manoukis/olfactometer_rotor/pics/buildings_s.jpg

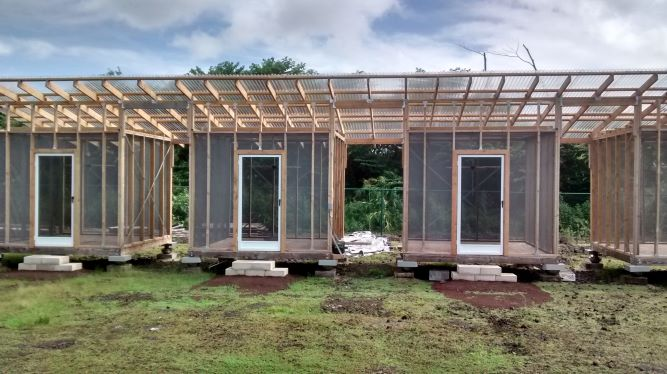
pics/buildings_s.jpg
