manoukis/olfactometer_rotor/pics/IMG_20181030_110219506.jpg

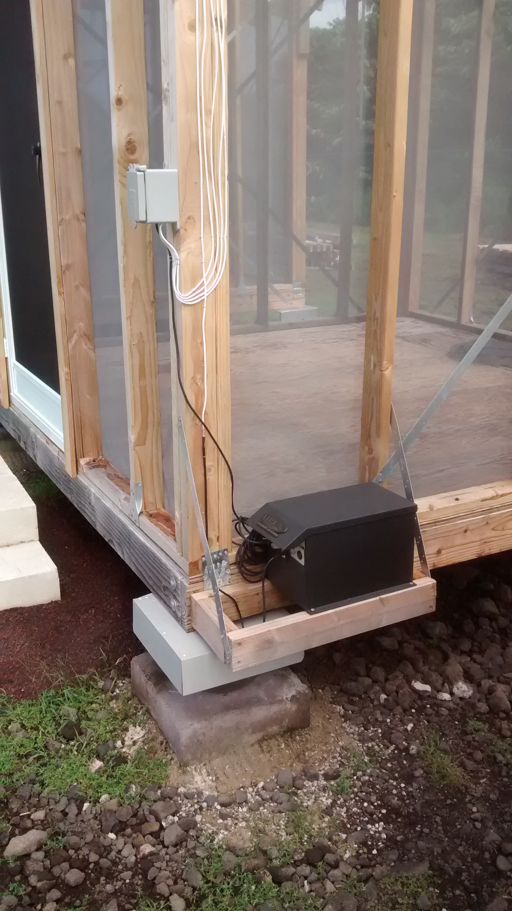
pics/IMG_20181030_110219506.jpg
