manoukis/olfactometer_rotor/README.md

# olfactometer_rotor
Designs for fly oflactometer (rotating traps)

See [PBARC Rotation Olfactometers- SOP 2018.docx](PBARC%20Rotating%20Olfactometers-%20SOP%202018.docx?raw=true) for docmentation
