manoukis/olfactometer_rotor/pics/IMG_20181030_110237050.jpg

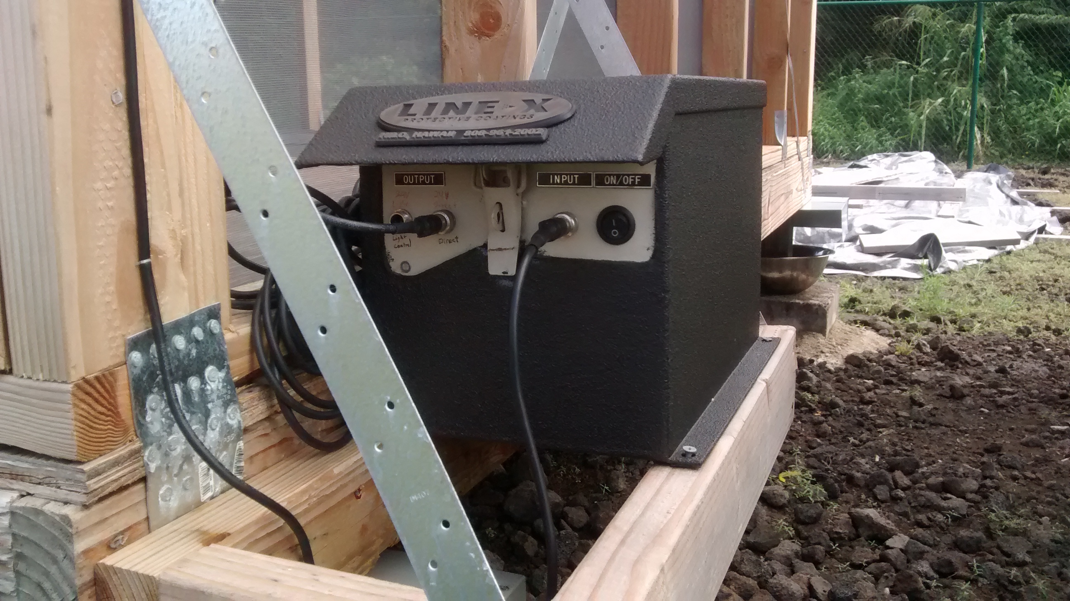
pics/IMG_20181030_110237050.jpg
