manoukis/olfactometer_rotor/pics/IMG_20181030_110251892.jpg

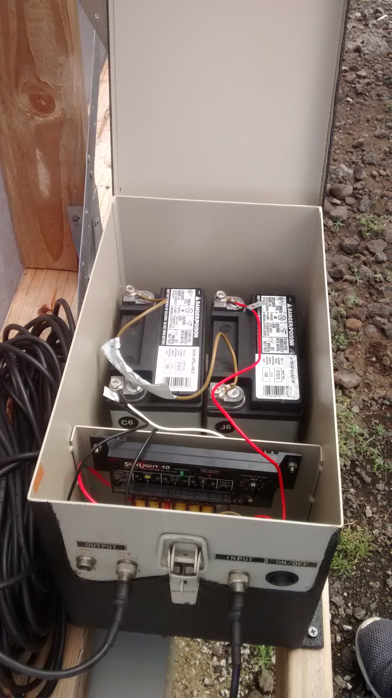
pics/IMG_20181030_110251892.jpg
