manoukis/olfactometer_rotor/pics/IMG_20181030_110327771.jpg

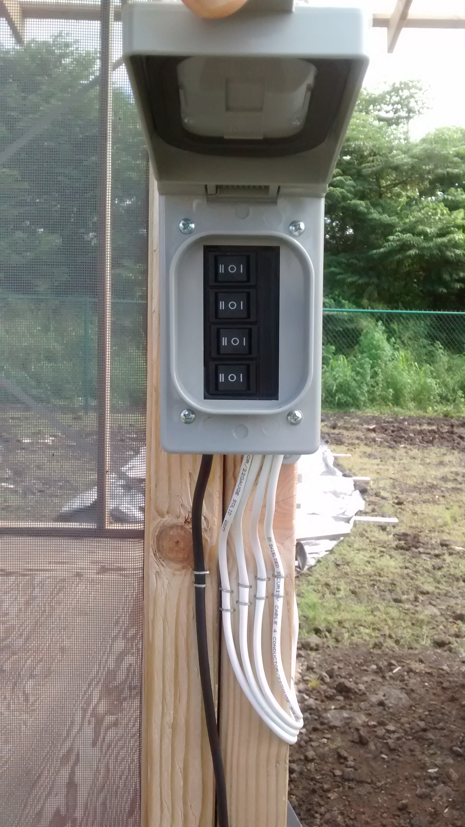
pics/IMG_20181030_110327771.jpg
