manoukis/olfactometer_rotor/pics/IMG_20181030_110353957.jpg

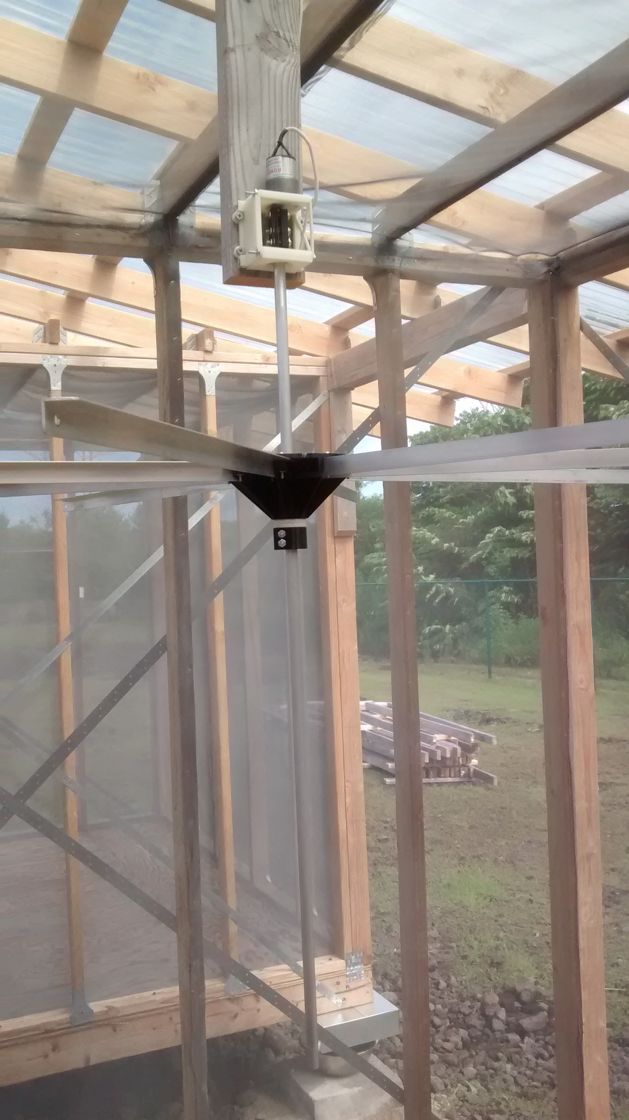
pics/IMG_20181030_110353957.jpg
