manoukis/olfactometer_rotor/pics/IMG_20181030_110401536.jpg

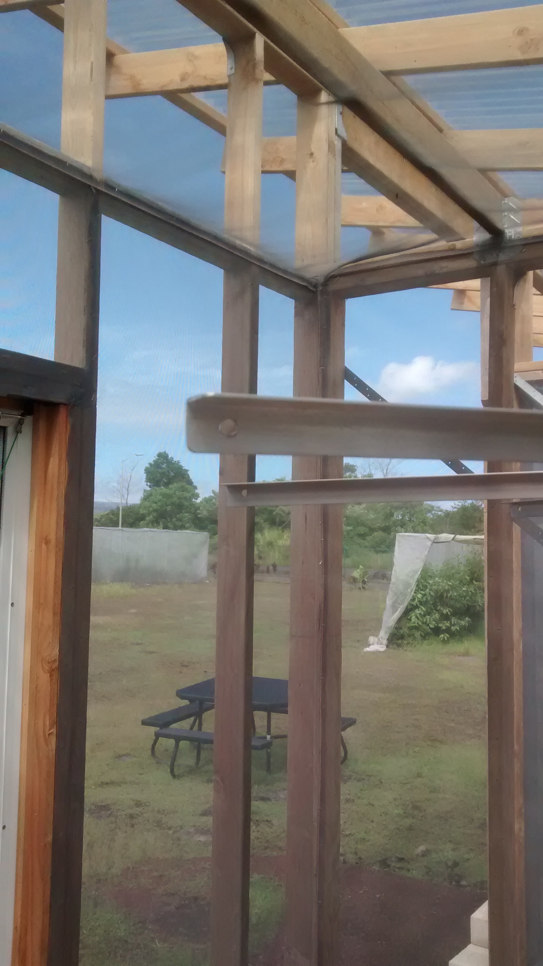
pics/IMG_20181030_110401536.jpg
