manoukis/olfactometer_rotor/pics/IMG_20181030_110407331.jpg

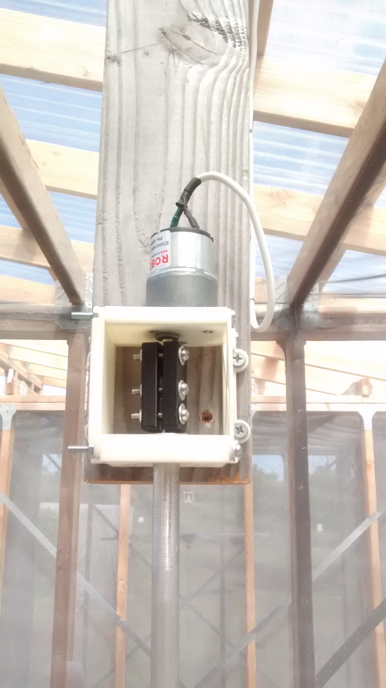
pics/IMG_20181030_110407331.jpg
