manoukis/olfactometer_rotor/pics/IMG_20181030_110427534.jpg

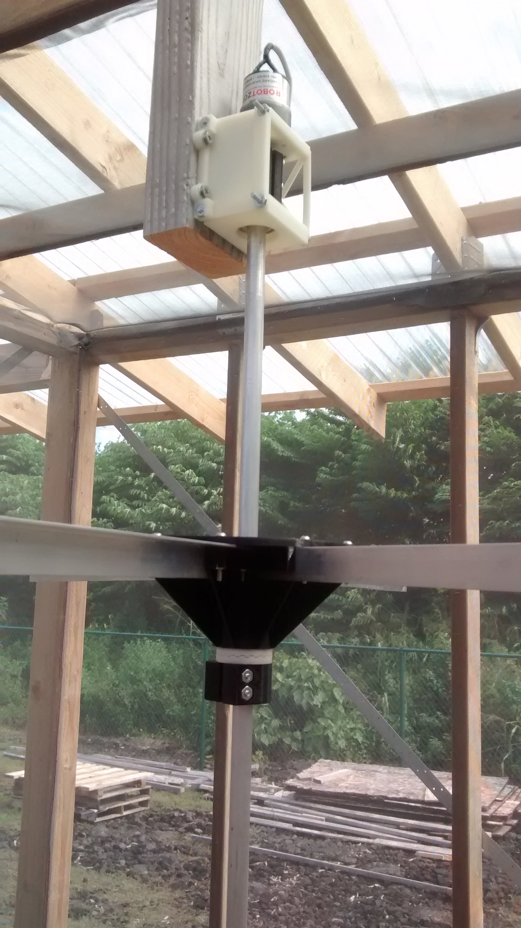
pics/IMG_20181030_110427534.jpg
