manoukis/olfactometer_rotor/pics/originals/IMG_20181030_110201760.jpg

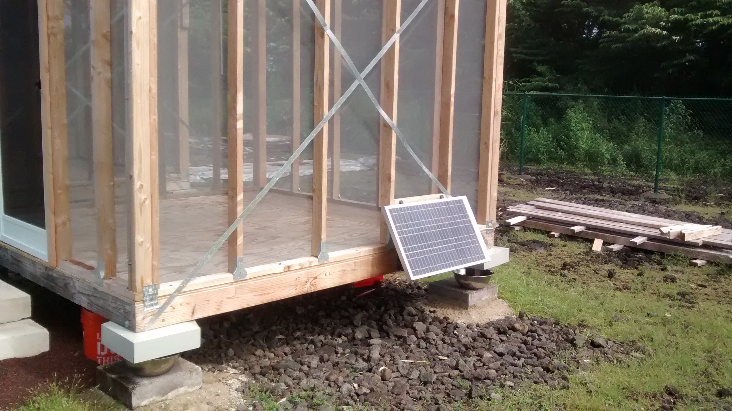
pics/originals/IMG_20181030_110201760.jpg
