manoukis/olfactometer_rotor/pics/solar_panel_s.jpg

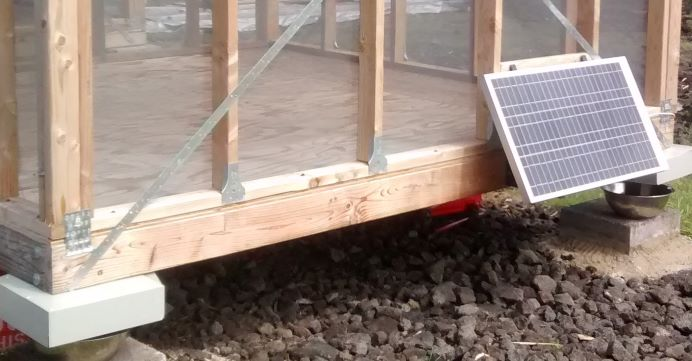
pics/solar_panel_s.jpg
