manoukis/olfactometer_rotor/part_designs/bearing_plate_v0.2.FCStd

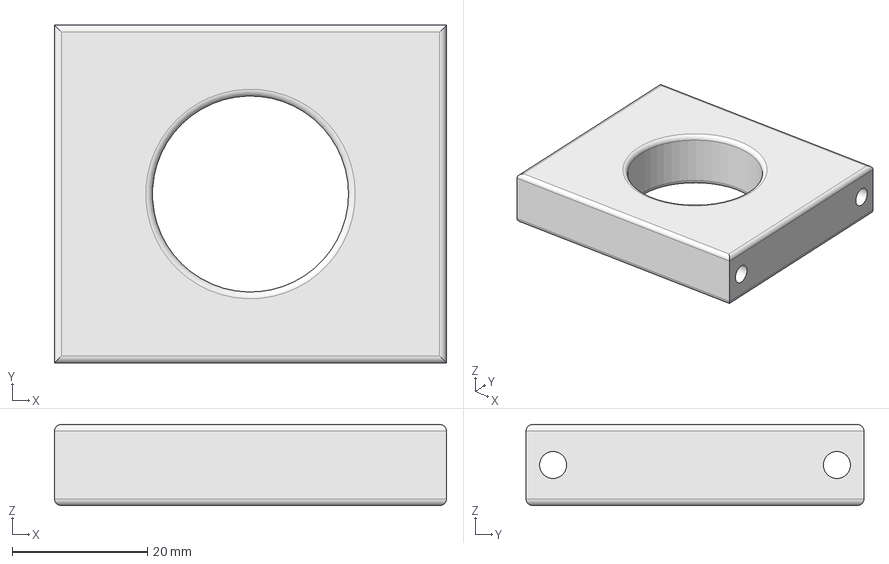
[picture p15: CAD file, 2018-10-17]
part_designs/bearing_plate_v0.2.FCStd
58.0 x 50.0 x 12.0 mm
