manoukis/olfactometer_rotor/part_designs/box_side_v0.8.FCStd

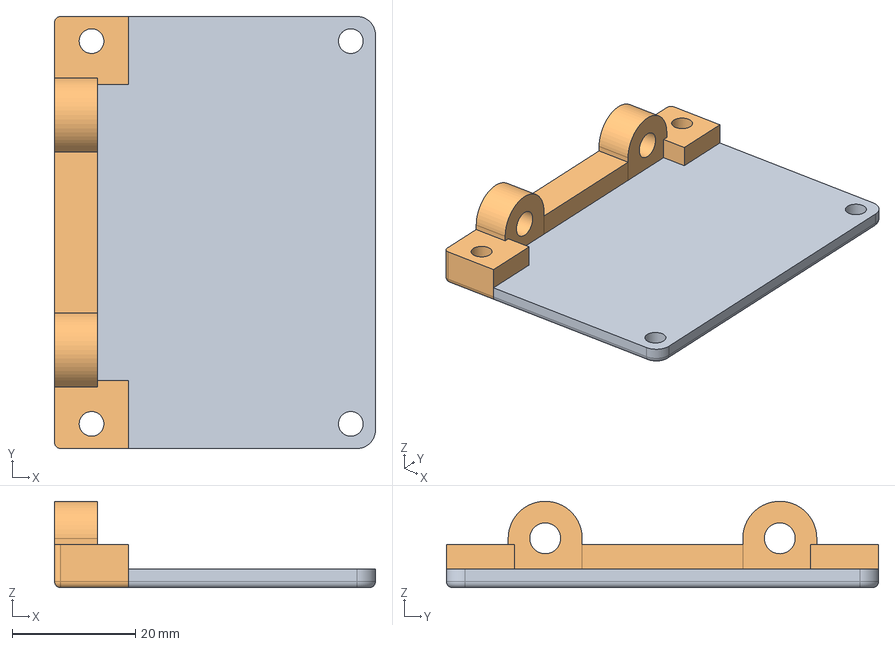
[picture p17: CAD file, 2018-10-17]
part_designs/box_side_v0.8.FCStd
52.0 x 70.0 x 14.0 mm
