manoukis/olfactometer_rotor/part_designs/mount plate_v0.4.FCStd

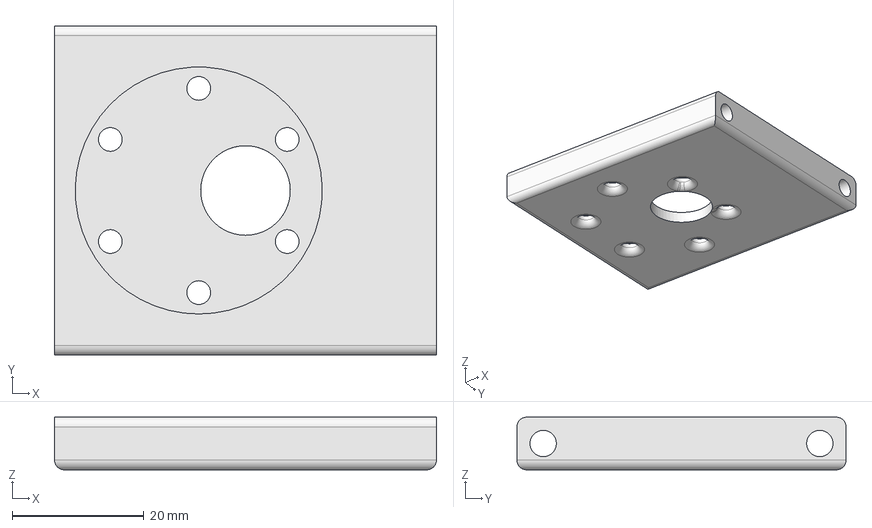
[picture p18: CAD file, 2018-10-17]
part_designs/mount plate_v0.4.FCStd
58.0 x 50.0 x 8.00 mm
