manoukis/olfactometer_rotor/part_designs/clamp_v0.8.FCStd

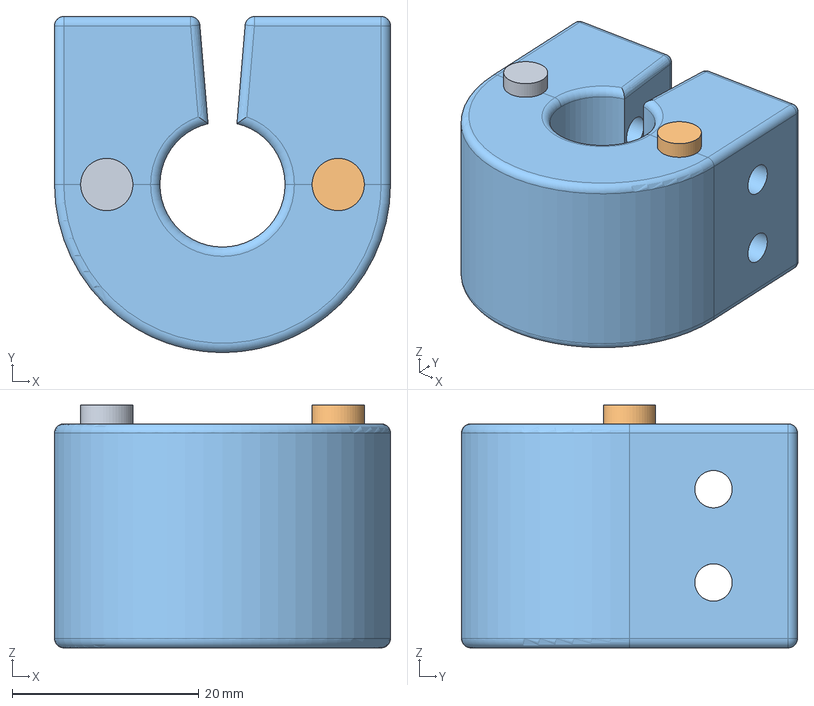
[picture p19: CAD file, 2018-10-10]
part_designs/clamp_v0.8.FCStd
36.0 x 36.0 x 26.0 mm
pin
pin001
