manoukis/olfactometer_rotor/part_designs/octoweb_top_v0.7.1.FCStd

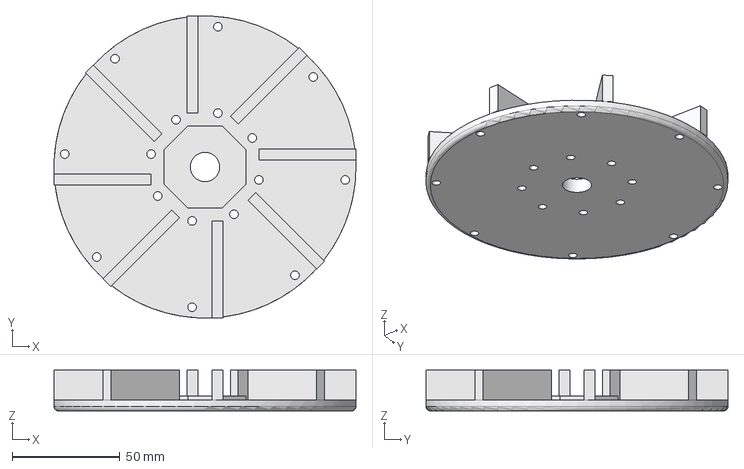
[picture p20: CAD file, 2018-10-09]
part_designs/octoweb_top_v0.7.1.FCStd
140.0 x 140.0 x 19.0 mm
