manoukis/olfactometer_rotor/part_designs/octoclutch_v0.7.FCStd

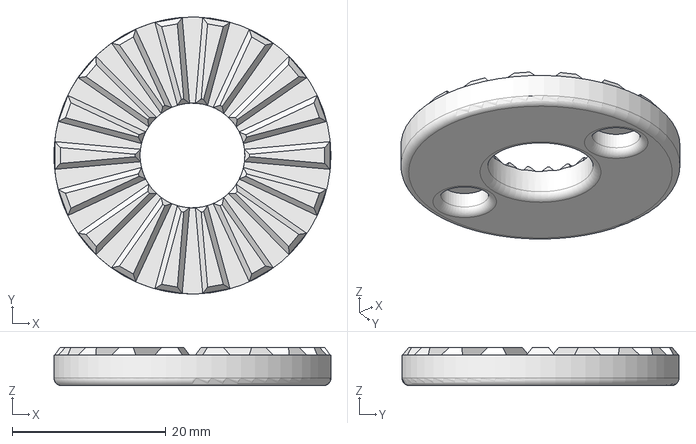
[picture p21: CAD file, 2018-10-09]
part_designs/octoclutch_v0.7.FCStd
36.0 x 36.0 x 5.00 mm
