manoukis/olfactometer_rotor/part_designs/coupler_v0.4.FCStd

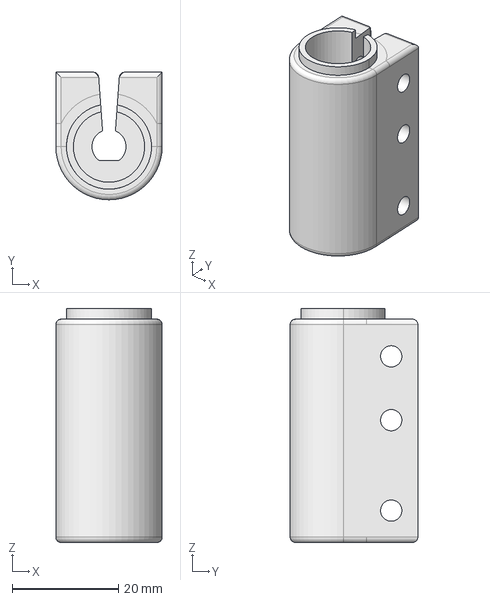
[picture p22: CAD file, 2018-10-09]
part_designs/coupler_v0.4.FCStd
20.0 x 24.0 x 44.0 mm
