manoukis/olfactometer_rotor/part_designs/octoweb_v0.8.1.FCStd

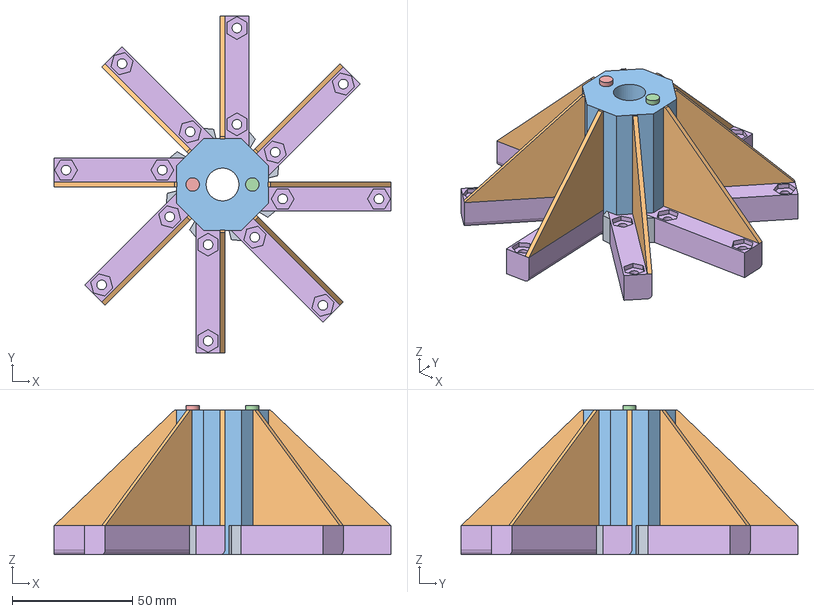
[picture p23: CAD file, 2018-10-09]
part_designs/octoweb_v0.8.1.FCStd
140.0 x 140.0 x 62.0 mm
pin
pin001
