manoukis/olfactometer_rotor/part_designs/switch_plate_v0.1.FCStd

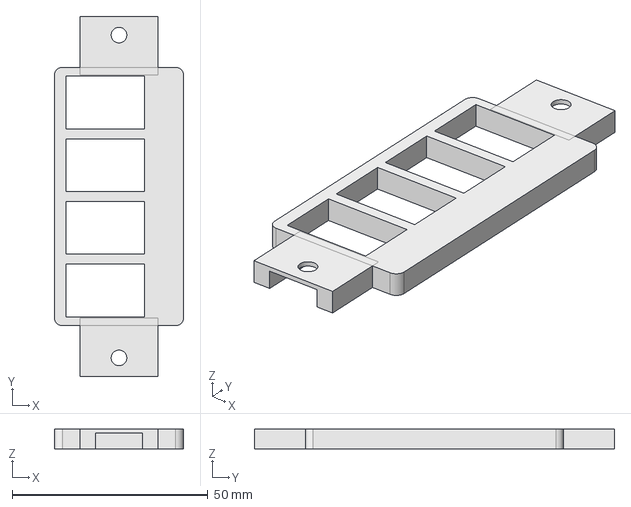
[picture p24: CAD file, 2018-10-09]
part_designs/switch_plate_v0.1.FCStd
33.0 x 92.0 x 5.00 mm
