manoukis/olfactometer_rotor/(list of files, cad)

Other CAD files:
part_designs/bearing_plate_v0.2.stl
part_designs/box_side_nuts_v0.8.stl
part_designs/box_side_v0.8.stl
part_designs/clamp_v0.8.stl
part_designs/coupler_v0.4.stl
part_designs/mount plate_v0.4.stl
part_designs/octoclutch_v0.7.stl
part_designs/octoweb_top_v0.7.1.stl
part_designs/octoweb_v0.8.1.stl
part_designs/switch_plate_v0.1.stl
