manoukis/olfactometer_rotor/(commit log)

2018-10-10 Two pins on clamp
    [clamp_v0.7.stl, clamp_v0.8.FCStd, clamp_v0.8.stl]
2018-10-17 Updated designs... Final?
    [bearing_plate_v0.2.FCStd, bearing_plate_v0.2.stl, box_side_nuts_v0.8.FCStd, box_side_nuts_v0.8.stl, box_side_v0.6.FCStd, box_side_v0.6.stl, box_side_v0.8.FCStd, box_side_v0.8.stl]
